openxc/simple-hud/schematics/README.txt

README:

LED_VU_BT_R1.1

Known issues:
-The footprint for D1, D2 is backwards - parts will need to be soldered by hand.
-See LED_VU_BT.brd.png for solder placement on SJ1-5
-Do not apply any solder / bridge SJ6
-Do Not Populate header J1
