openxc/simple-hud/schematics/LED_VU_BT.brd.png

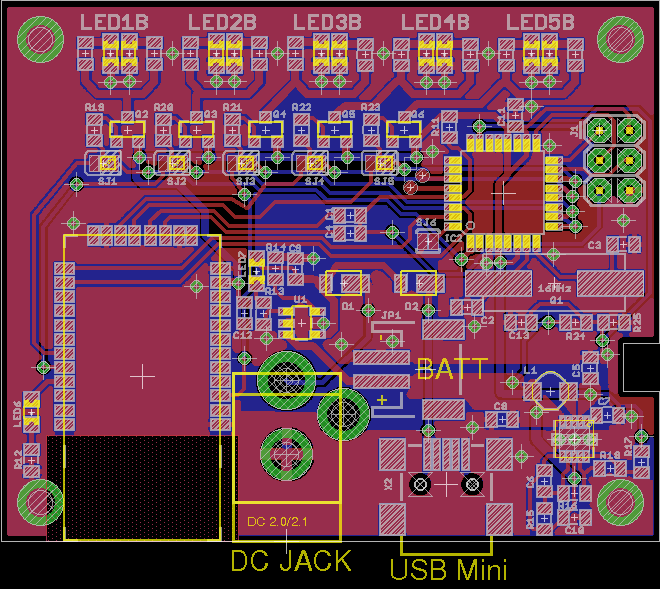
schematics/LED_VU_BT.brd.png
