openxc/simple-hud/schematics/LED_VU_BT.sch.png

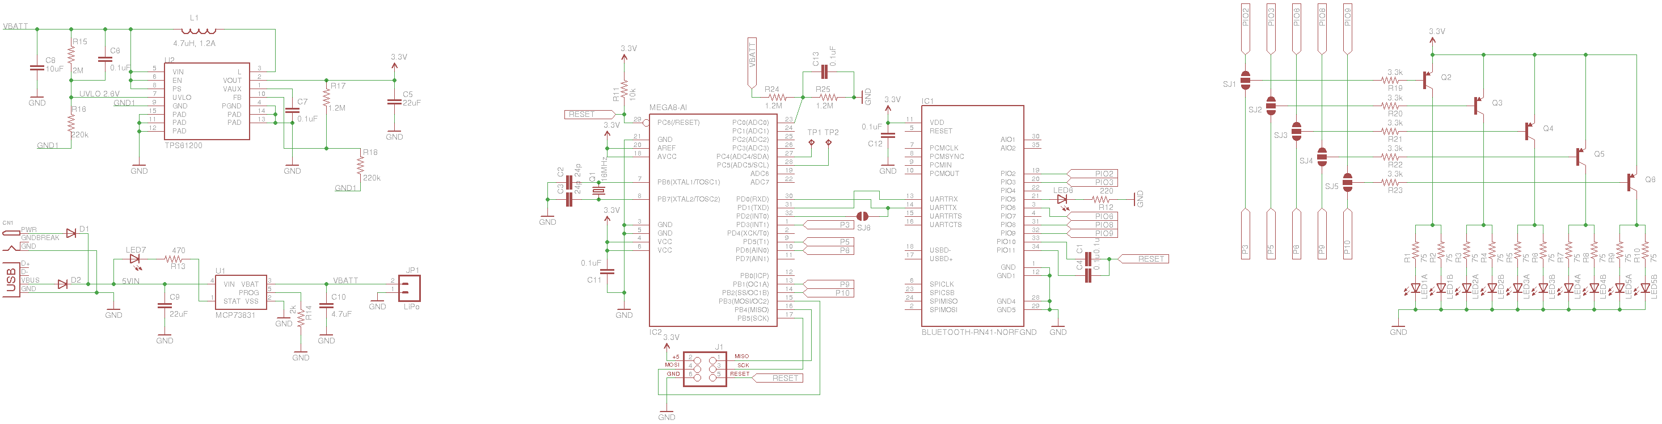
schematics/LED_VU_BT.sch.png
