openxc/simple-hud/schematics/LED_VU_BT_BOM.xls

Sheet: Sheet1
Part | Value | Package | Manu | Part # | Dist. | Q/Brd | Quant | Library | Comments
JP1 |  | 1X06_1MM_JST_SH_HORZ | 4UCON | PRT-10210 (http://www.sparkfun.com/products/10210) | SparkFun | 1 | 7 | BUG | Connector
- |  | - |  | PRT-10361 (http://www.sparkfun.com/products/10361) | SparkFun | 1 | 7 | - | Cable assembly
R1-10 | 75 | 0805 | Bourns | CR0805-FX-75R0GLF (http://www.mouser.com/ProductDetail/Bourns/CR0805-FX-75R0GLF/) | Mouser | 10 | 60 | BUG | High current (25mA) Blue Alternative
R1-10 | 180 | 0805 | Bourns | CR0805-FX-1800GLF (http://www.mouser.com/ProductDetail/Bourns/CR0805-FX-1800GLF/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) | Mouser | 10 | 60 | BUG | Lower current (10mA) Alternative
R1-10 | 88.7 | 0805 | Bourns | CR0805-FX-88R7ELF (http://www.mouser.com/ProductDetail/Bourns/CR0805-FX-88R7ELF/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) | Mouser | 10 | 60 | BUG | High current (19mA) Green Alternative
LED1A-5B | Blue | CHIPLED_0805 | Dialight | 598-8191-107F (http://www.mouser.com/ProductDetail/Dialight/598-8191-107F/?qs=sGAEpiMZZMtEjy7lsqBi5TMaylv1X7iuazk6ETMb3kc%3D) | Mouser | 10 | 55 | adafruit
LED1A-5B | Green | CHIPLED_0805 | Kingbright | APHCM2012ZGC-F01 (http://www.mouser.com/ProductDetail/Kingbright/APHCM2012ZGC-F01/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) | Mouser | 10 | 55 | adafruit
LED1A-5B | White | CHIPLED_0805 | Lite-On | LTW-170TK (http://www.mouser.com/ProductDetail/Lite-On/LTW-170TK/?qs=sGAEpiMZZMtEjy7lsqBi5dA5cFAwnWtUMw7IycIA7CE%3D) | Mouser | 0 | 0 | adafruit | White LED Alternative

Sheet: Sheet2
Part | Value | Package | Manu | Part #
C1 | 0.1uF | 805 | TDK | C2012Y5V1H104ZT/0.60
C2 | 24pF | 805 | Murata | GRM2165C1H240JZ01D
C3 | 24pF | 805 | Murata | GRM2165C1H240JZ01D
C4 | 0.1uF | 805 | TDK | C2012Y5V1H104ZT/0.60
C5 | 22uF | 805 | TDK | C2012X5R0J226MT/1.25
C6 | 0.1uF | 805 | TDK | C2012Y5V1H104ZT/0.60
C7 | 0.1uF | 805 | TDK | C2012Y5V1H104ZT/0.60
C8 | 10uF | 805 | TDK | C2012Y5V1A106ZT
C9 | 22uF | 805 | TDK | C2012X5R1A226MT/1.25
C10 | 4.7uF | 805 | TDK | C2012Y5V1C475ZT
C11 | 0.1uF | 805 | TDK | C2012Y5V1H104ZT/0.60
C12 | 0.1uF | 805 | TDK | C2012Y5V1H104ZT/0.60
C13 | 0.1uF | 805 | TDK | C2012Y5V1H104ZT/0.60
CN1 |  | DCJACK_2MM_PTH | CUI | PJ-035D
D1 |  | POWERDI123 | Diodes Inc. | SBR2M30P1-7
D2 |  | POWERDI123 | Diodes Inc. | SBR2M30P1-7
IC1 | BLUETOOTH-RN41-NORFGND | RN41_NORFPAD | Roving Networks | RN-42
IC2 | MEGA8-AI | TQFP32-08 | Atmel | ATMEGA328P-AUR
J1 | DNP | 2X3 | DNP | DNP
JP1 | LiPo | JST-2-SMD | JST | S2B-PH-SM4-TB
L1 | 4.7uH,1.2A | CDRH2D09 | Sumida | CDRH2D09NP-4R7MC
LED1A | Green | CHIPLED_0805 | Kingbright | APHCM2012ZGC-F01
LED1B | Green | CHIPLED_0805 | Kingbright | APHCM2012ZGC-F01
LED2A | Green | CHIPLED_0805 | Kingbright | APHCM2012ZGC-F01
LED2B | Green | CHIPLED_0805 | Kingbright | APHCM2012ZGC-F01
LED3A | Green | CHIPLED_0805 | Kingbright | APHCM2012ZGC-F01
LED3B | Green | CHIPLED_0805 | Kingbright | APHCM2012ZGC-F01
LED4A | Green | CHIPLED_0805 | Kingbright | APHCM2012ZGC-F01
LED4B | Green | CHIPLED_0805 | Kingbright | APHCM2012ZGC-F01
LED5A | Green | CHIPLED_0805 | Kingbright | APHCM2012ZGC-F01
LED5B | Green | CHIPLED_0805 | Kingbright | APHCM2012ZGC-F01
LED6 | Green | CHIPLED_0805 | Kingbright | APHCM2012ZGC-F01
LED7 | Green | CHIPLED_0805 | Kingbright | APHCM2012ZGC-F01
Q1 | 16MHz | HC49USX | ECS | ECS-80-20-5PXDU-TR
Q2 | PNP | SOT23-3 | Fairchild | MMBT2907A_D87Z
Q3 | PNP | SOT23-3 | Fairchild | MMBT2907A_D87Z
Q4 | PNP | SOT23-3 | Fairchild | MMBT2907A_D87Z
Q5 | PNP | SOT23-3 | Fairchild | MMBT2907A_D87Z
Q6 | PNP | SOT23-3 | Fairchild | MMBT2907A_D87Z
R1 | 0 | 0805 | Bourns | CR0805-J/-000ELF
R2 | 0 | 0805 | Bourns | CR0805-J/-000ELF
R3 | 0 | 0805 | Bourns | CR0805-J/-000ELF
R4 | 0 | 0805 | Bourns | CR0805-J/-000ELF
R5 | 0 | 0805 | Bourns | CR0805-J/-000ELF
R6 | 0 | 0805 | Bourns | CR0805-J/-000ELF
R7 | 0 | 0805 | Bourns | CR0805-J/-000ELF
R8 | 0 | 0805 | Bourns | CR0805-J/-000ELF
R9 | 0 | 0805 | Bourns | CR0805-J/-000ELF
R10 | 0 | 0805 | Bourns | CR0805-J/-000ELF
R11 | 10k | 0805 | Bourns | CR0805-FX-1002ELF
R12 | 220 | 0805 | Bourns | CR0805-FX-2200GLF
R13 | 470 | 0805 | Bourns | CR0805-FX-4700GLF
R14 | 2k | 0805 | Bourns | CR0805-FX-2001ELF
R15 | 2M | 0805 | Bourns | CR0805-JW-205ELF
R16 | 220k | 0805 | Bourns | CR0805-FX-2203ELF
R17 | 1.2M | 0805 | Bourns | CR0805-FX-1204ELF
R18 | 220k | 0805 | Bourns | CR0805-FX-2203ELF
R19 | 3.3k | 0805 | Bourns | CR0805-FX-3301GLF
R20 | 3.3k | 0805 | Bourns | CR0805-FX-3301GLF
R21 | 3.3k | 0805 | Bourns | CR0805-FX-3301GLF
R22 | 3.3k | 0805 | Bourns | CR0805-FX-3301GLF
R23 | 3.3k | 0805 | Bourns | CR0805-FX-3301GLF
R24 | 1.2M | 0805 | Bourns | CR0805-FX-1204ELF
R25 | 1.2M | 0805 | Bourns | CR0805-FX-1204ELF
SJ1 | - | SJ_3_PASTE1&2 | - | -
SJ2 | - | SJ_3_PASTE1&2 | - | -
SJ3 | - | SJ_3_PASTE1&2 | - | -
SJ4 | - | SJ_3_PASTE1&2 | - | -
SJ5 | - | SJ_3_PASTE1&2 | - | -
SJ6 | - | SJ_2S-NO | - | -
U1 | MCP73831 | SOT23-5 | Microchip | MCP73831
U2 | TPS61200 | QFN-10_PAD | TI | TPS61200
X2 | USBSMD | USB-MINIB | SparkFun | PRT-00587 | MUSB-05-S-B-SM-A
