openxc/simple-hud/assembly/solar-panel.png

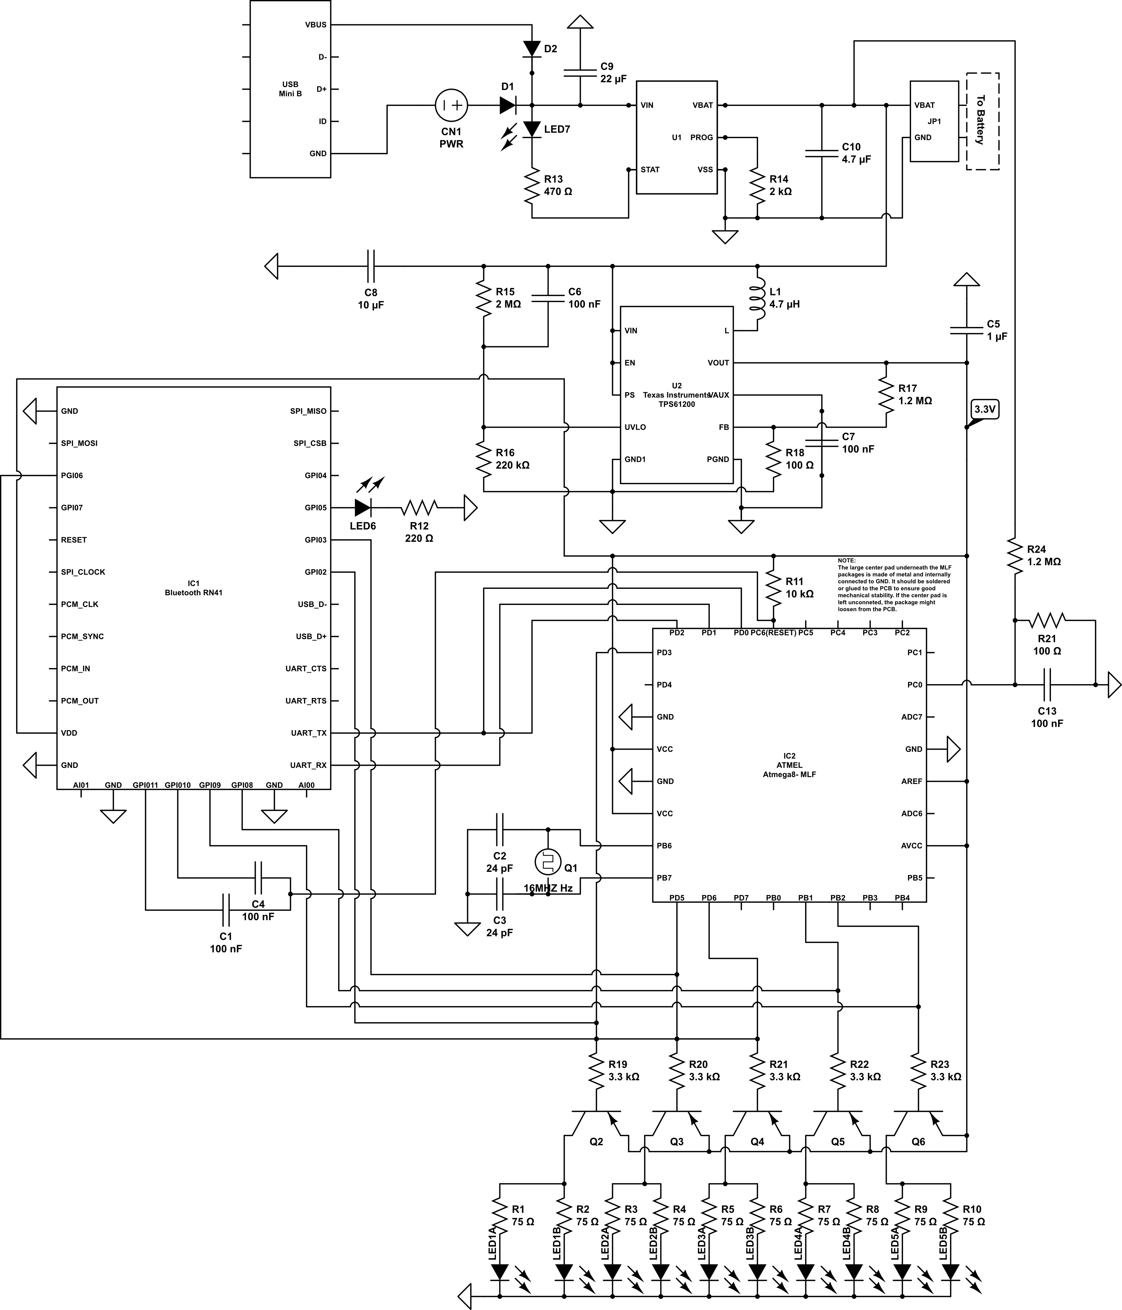
assembly/solar-panel.png
