openxc/simple-hud/(commit log)

2012-02-21 Initial commit (moved from private Bug Labs / Ford repo).
    [LED_VU_BT_firmware.pde]
2012-02-21 Add assembly version of firmware for HUD.
    [LED_VU_BT.brd, LED_VU_BT.sch, LED_VU_BT_BOM.xls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]
2012-03-06 Port (roughly) the DeviceListener to Android.
2012-03-07 Do service discovery in a background thread.
2012-03-19 Only unregister the receiver if we previously tried to discover devices.
2012-03-19 Re-enable the keepalive thread for bluetooth devices.
2012-03-20 Shortcut device connection if we're already discovered and paired.
2012-03-20 Shutdown all threads properly.
2012-07-31 Add an updated and clearer version of the circuit diagram.
2013-01-08 change name from LED VU bar to Bluetooth HUD
2013-01-09 Re-organize project to match retro-gauge.
    [LED_VU_BT.brd, LED_VU_BT.sch, LED_VU_BT_BOM.xls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]
